JitterCompany/uartwise/pcb/serial-logger-prototype.xlsx

Sheet: BOM
Sync | Ref | Qty | Value | Footprint | MPN | Farnell | Mouser | required | stock | 2
 |  | 1 |  |  |  |  | 534-1043 | 2 |  |  | extra/alt om te proberen
1 | BT1, | 1 | Battery_Cell | Jitter_Footprints:BatteryHolder_Keystone_1043(p)_1x18650 | 1043P |  | 534-1043P | 2
1 | C1, C4, C14, C16, C13, | 5 | 100nF | Capacitor_SMD:C_0402_1005Metric |  | 2896350 |  | 10
1 | C2, C9, C7, C8, C12, C11, C18, C17, | 8 | 4.7µF | Capacitor_SMD:C_0805_2012Metric |  | 2611942 |  | 16
1 | C3, C6, | 2 | 1.0µF | Capacitor_SMD:C_0603_1608Metric |  |  |  | 0 | 12
1 | C10, C15, C5, C19, C20, | 5 | 10nF | Capacitor_SMD:C_0402_1005Metric |  | 2470416 |  | 10
1 | H1, | 1 | ELW2106AA | Jitter_Footprints:Molex_503480-1400-1x14-1MP_P0.5mm_Horizontal | 503480-1400 | 3215747 |  | 2
1 | J1, | 1 | JTAG/SWD | Connector_PinHeader_1.27mm:PinHeader_2x05_P1.27mm_Vertical_SMD | FTSH-105-01-L-DV-K-P | 2856437 | 200-FTSH10501LDVKP | 2
1 | J2, | 1 | Conn_01x04_Female | Connector_PinSocket_2.54mm:PinSocket_1x04_P2.54mm_Vertical |  | 1593460 |  | 2
1 | J3, | 1 | Conn_01x04_Male | Connector_PinHeader_2.54mm:PinHeader_1x04_P2.54mm_Horizontal |  | 2888929 |  | 2
1 | J4, | 1 | Conn_01x03_Male | Connector_PinHeader_2.54mm:PinHeader_1x03_P2.54mm_Vertical |  |  |  | 0 | 5
1 | L1, | 1 | 22µH | Inductor_SMD:L_1812_4532Metric | LQH43PN220M26L | 2219279 |  | 2
1 | R2, R1, | 2 | 220 | Resistor_SMD:R_0402_1005Metric |  | 2614287 |  | 4
1 | R7, R5, R13, | 3 | 10k | Resistor_SMD:R_0603_1608Metric |  | 1469748 |  | 6
1 | R8, R6, R3, R4, R12, | 5 | 10k | Resistor_SMD:R_0402_1005Metric |  | 1738864 |  | 10
1 | R9, R10, | 2 | 47 | Resistor_SMD:R_0402_1005Metric |  | 9232605 |  | 4
1 | R11, | 1 | 1.1M | Resistor_SMD:R_0402_1005Metric |  | 2694532 |  | 2
1 | R14, | 1 | 56k | Resistor_SMD:R_0402_1005Metric |  | 2447198 |  | 2
1 | SW1, | 1 | Rotary_Encoder_Switch_DualLED | Jitter_Footprints:PEL12D-4xxxS-Sxxxx | PEL12D-4225S-S2024 |  | 652-PEL12D4225SS2024 | 2
1 | SW2, | 1 | SW_SPDT | Jitter_Footprints:slide_switch_09.03201.02 | 09.03201.02 | 1608080 |  | 2
1 | U1, | 1 | STM32G070KBT6 | Package_QFP:LQFP-32_7x7mm_P0.8mm | STM32G070KBT6 | 3365394 | 511-STM32G070KBT6 | 2
1 | U2, | 1 | 74LVC3G17 | Package_SO:TSSOP-8_3x3mm_P0.65mm | SN74LVC3G17DCT | 1236391 |  | 2
1 | U3, | 1 | TLV70228_SOT23-5 | Package_TO_SOT_SMD:SOT-23-5 | TLV70228DBVT | 2492371 |  | 2
1 | U4, U6, | 2 | sn74lv1t34 | Package_TO_SOT_SMD:SOT-23-5 | SN74LV1T34DBVR | 3119564 | 595-SN74LV1T34DBVR | 4
1 | U5, | 1 | TLV61046ADB | Package_TO_SOT_SMD:SOT-23-6 | TLV61046ADBV | 3007283 |  | 2
 |  |  |  |  |  |  |  | 0
 |  |  |  |  |  |  |  | 0
 |  |  |  |  |  |  |  | 0
1 | TP1, TP2, TP5, TP6, TP7, TP8, TP9, | 7 | TestPoint | TestPoint:TestPoint_Pad_D1.0mm |  |  |  | 0 | 14
1 | TP4, TP3, | 2 | TestPoint | TestPoint:TestPoint_Pad_D1.5mm |  |  |  | 0 | 4
 |  |  |  |  |  |  |  | 0
 |  |  |  |  |  |  |  | 0
 |  | 1 |  | display | ELW2106AA |  | 387-ELW2106AA | 1 | 1
 |  | 3 |  | M2x14 (of M2x15, misschien zelfs x16?) |  | 2494515 |  | 6

Sheet: Sheet2
534-1043 | 2
534-1043P | 2
387-ELW2106AA | 1
200-FTSH10501LDVKP | 2
652-PEL12D4225SS2024 | 2
511-STM32G070KBT6 | 2
595-SN74LV1T34DBVR | 4
