JitterCompany/uartwise/pcb/production/Jitter-1111_L1-1__100x30__acryl-zwart-2mm.dxf

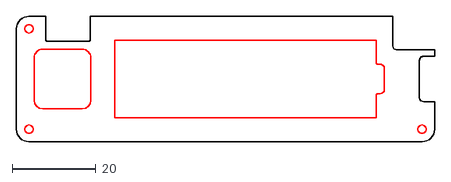
[picture p1: CAD file, 2020-02-04]
pcb/production/Jitter-1111_L1-1__100x30__acryl-zwart-2mm.dxf
100.0 x 30.0
