JitterCompany/uartwise/pcb/production/Jitter-1111_L2-1__100x30__acryl-transparant-2mm.dxf

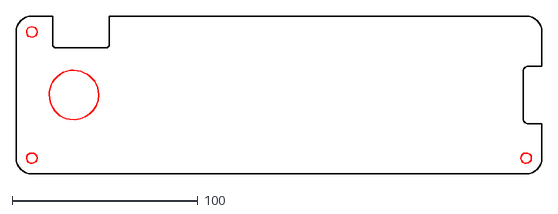
[picture p2: CAD file, 2020-02-04]
pcb/production/Jitter-1111_L2-1__100x30__acryl-transparant-2mm.dxf
283.5 x 85.0
