JitterCompany/uartwise/pcb/production/Jitter-1111_L0-1__100x30__acryl-zwart-6mm.dxf

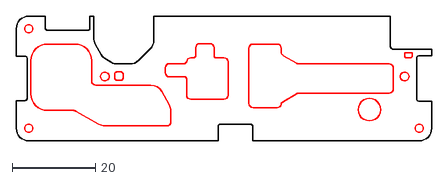
[picture p3: CAD file, 2020-02-04]
pcb/production/Jitter-1111_L0-1__100x30__acryl-zwart-6mm.dxf
100.0 x 30.0
