JitterCompany/uartwise/pcb/serial-logger-prototype.kicad_pcb

## KiCad design pcb/serial-logger-prototype.kicad_pcb (2020-03-20)

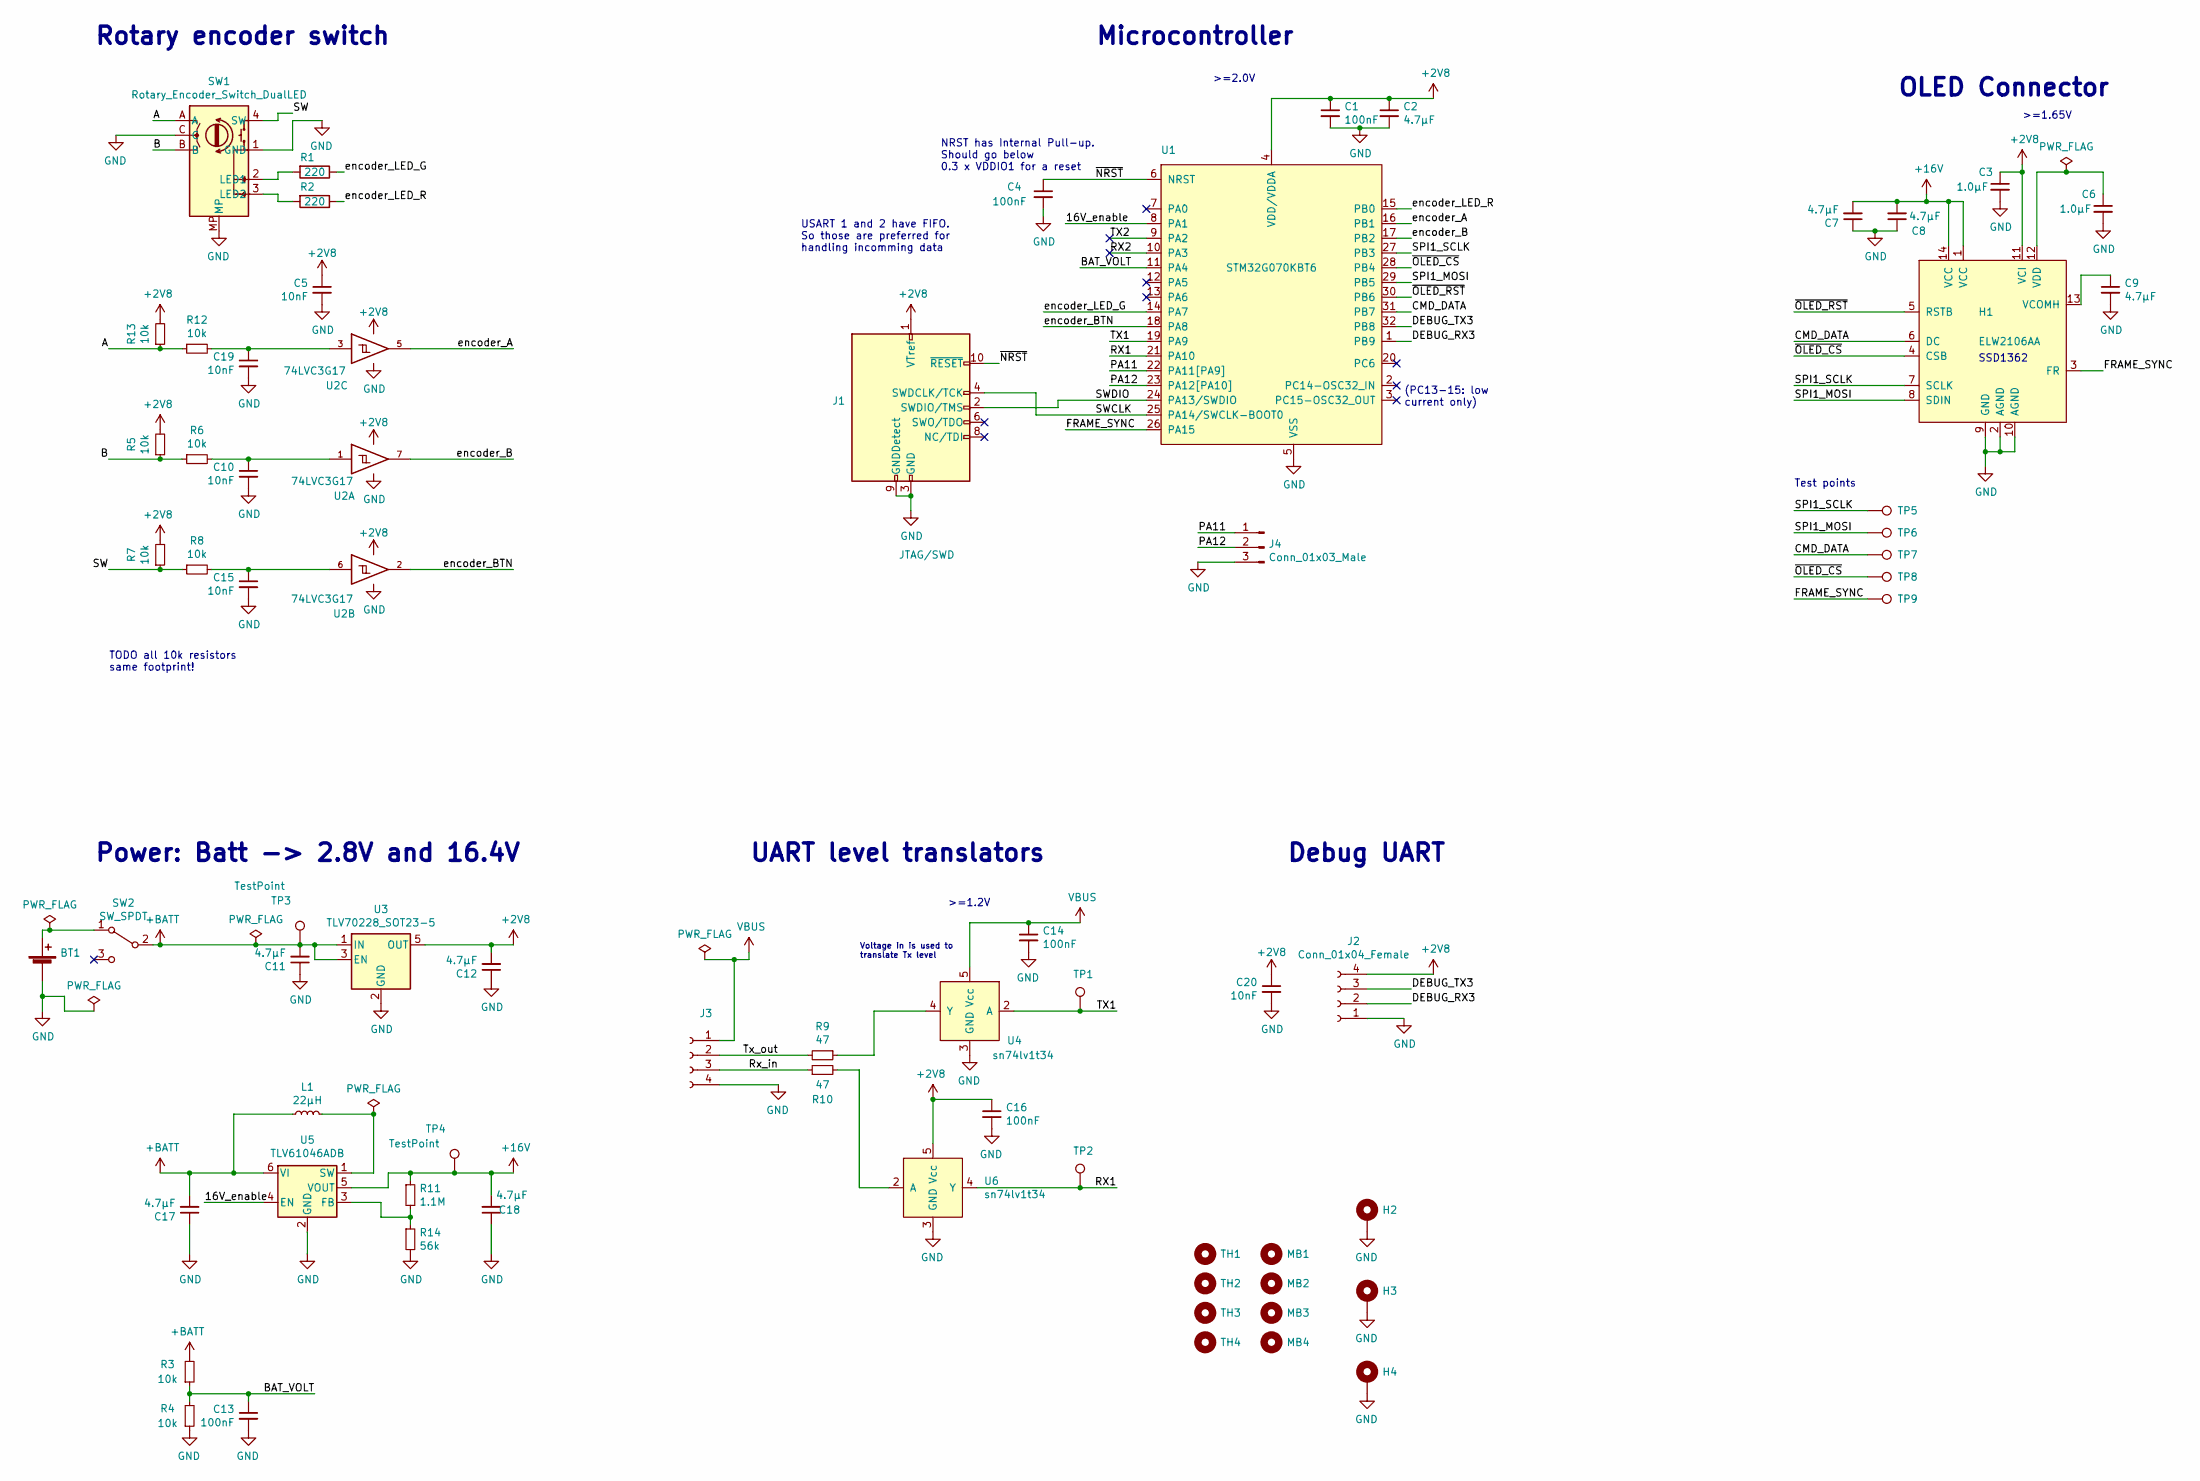
[picture p4: schematic serial-logger-prototype.sch]

Parts:
BT1: Battery_Cell; BatteryHolder_Keystone_1043(p)_1x18650; MPN 1043P; Mouser 534-1043P
C1, C4, C13, C14, C16: 100nF; C_0402_1005Metric
C2, C7, C8, C9, C11, C12, C17, C18: 4.7µF; C_0805_2012Metric
C3, C6: 1.0µF; C_0603_1608Metric
C5, C10, C15, C19, C20: 10nF; C_0402_1005Metric
H1: ELW2106AA; Molex_503480-1400-1x14-1MP_P0.5mm_Horizontal; MPN 503480-1400; Farnell 3215747
H2, H3, H4: DNI; MountingHole_2.2mm_M2_Pad_Via
J1: JTAG/SWD; PinHeader_2x05_P1.27mm_Vertical_SMD; MPN FTSH-105-01-L-DV-K-P; Farnell 2856437
J2: Conn_01x04_Female; PinSocket_1x04_P2.54mm_Vertical; Farnell 1593460
J3: Conn_01x04_Male; PinHeader_1x04_P2.54mm_Horizontal; Farnell 2888929
J4: Conn_01x03_Male; PinHeader_1x03_P2.54mm_Vertical
L1: 22µH; L_1812_4532Metric; MPN LQH43PN220M26L; Farnell 2219279
MB1, MB2, MB3, MB4: DNI; MouseBite_3.5mmx2.2mm_breakaway
R1, R2: 220; R_0402_1005Metric
R3, R4, R6, R8, R12: 10k; R_0402_1005Metric
R5, R7, R13: 10k; R_0603_1608Metric
R9, R10: 47; R_0402_1005Metric
R11: 1.1M; R_0402_1005Metric
R14: 56k; R_0402_1005Metric
SW1: Rotary_Encoder_Switch_DualLED; PEL12D-4xxxS-Sxxxx; MPN PEL12D-4225S-S2024; Mouser 652-PEL12D4225SS2024
SW2: SW_SPDT; slide_switch_09.03201.02; MPN 09.03201.02; Farnell 1608080
TH1, TH2, TH3, TH4: DNI; Tooling_hole_4mm_4.04mm_paste
TP1, TP2, TP5, TP6, TP7, TP8, TP9: TestPoint; TestPoint_Pad_D1.0mm
TP3, TP4: TestPoint; TestPoint_Pad_D1.5mm
U1: STM32G070KBT6; LQFP-32_7x7mm_P0.8mm; MPN STM32G070KBT6; Farnell 3365394
U2: 74LVC3G17; TSSOP-8_3x3mm_P0.65mm; MPN SN74LVC3G17DCT; Farnell 1236391
U3: TLV70228_SOT23-5; SOT-23-5; MPN TLV70228DBVT; Farnell 2492371
U4, U6: sn74lv1t34; SOT-23-5; MPN SN74LV1T34DBVR; Mouser 595-SN74LV1T34DBVR
U5: TLV61046ADB; SOT-23-6; MPN TLV61046ADBV; Farnell 3007283

Connections:
+2V8: C1.1, C2.1, C3.1, C5.1, C12.2, C16.1, C20.1, H1.11 (VCI), J1.1 (VTref), J2.4, R5.2, R7.2, R13.2, U1.4 (VDD/VDDA), U2.8 (VCC), U3.5 (OUT), U6.5 (Vcc)
+16V: C7.2, C8.2, C18.2, H1.1 (VCC), H1.14 (VCC), R11.1, TP4.1, U5.5 (VOUT)
+BATT: C11.2, C17.2, L1.1, R3.2, SW2.2 (B), TP3.1, U3.1 (IN), U3.3 (EN), U5.6 (VI)
/16V_enable: U1.8 (PA1), U5.4 (EN)
/A: R12.1, R13.1, SW1.A
/B: R5.1, R6.1, SW1.B
/BAT_VOLT: C13.1, R3.1, R4.2, U1.11 (PA4)
/CMD_DATA: H1.6 (DC), TP7.1, U1.31 (PB7)
/DEBUG_RX3: J2.2, U1.1 (PB9)
/DEBUG_TX3: J2.3, U1.32 (PB8)
/FRAME_SYNC: H1.3 (FR), TP9.1, U1.26 (PA15)
/PA11: J4.1, U1.22 (PA11[PA9])
/PA12: J4.2, U1.23 (PA12[PA10])
/RX1: TP2.1, U1.21 (PA10), U6.4 (Y)
/Rx_in: J3.3, R10.1
/SPI1_MOSI: H1.8 (SDIN), TP6.1, U1.29 (PB5)
/SPI1_SCLK: H1.7 (SCLK), TP5.1, U1.27 (PB3)
/SW: R7.1, R8.1, SW1.4 (SW)
/SWCLK: J1.4 (SWDCLK/TCK), U1.25 (PA14/SWCLK-BOOT0)
/SWDIO: J1.2 (SWDIO/TMS), U1.24 (PA13/SWDIO)
/TX1: TP1.1, U1.19 (PA9), U4.2 (A)
/Tx_out: J3.2, R9.2
/encoder_A: U1.16 (PB1), U2.5
/encoder_B: U1.17 (PB2), U2.7
/encoder_BTN: U1.18 (PA8), U2.2
/encoder_LED_G: R1.1, U1.14 (PA7)
/encoder_LED_R: R2.1, U1.15 (PB0)
/~NRST: C4.1, J1.10 (~RESET~), U1.6 (NRST)
/~OLED_CS: H1.4 (CSB), TP8.1, U1.28 (PB4)
/~OLED_RST: H1.5 (RSTB), U1.30 (PB6)
GND: BT1.2 (-), C1.2, C2.2, C3.2, C4.2, C5.2, C6.2, C7.1, C8.1, C9.2, C10.2, C11.1, C12.1, C13.2, C14.2, C15.2, C16.2, C17.1, C18.1, C19.2, C20.2, H1.2 (AGND), H1.9 (GND), H1.10 (AGND), H2.1, H3.1, H4.1, J1.3 (GND), J1.5 (GND), J1.9 (GNDDetect), J2.1, J3.4, J4.3, R4.1, R14.2, SW1.1 (GND), SW1.C, SW1.MP, U1.5 (VSS), U2.4 (GND), U3.2 (GND), U4.3 (GND), U5.2 (GND), U6.3 (GND)
unnamed: BT1.1 (+), SW2.1 (A)
unnamed: C6.1, H1.12 (VDD)
unnamed: C9.1, H1.13 (VCOMH)
unnamed: C10.1, R6.2, U2.1
unnamed: C15.1, R8.2, U2.6
unnamed: C19.1, R12.2, U2.3
unnamed: L1.2, U5.1 (SW)
unnamed: R1.2, SW1.2 (LED1)
unnamed: R2.2, SW1.3 (LED2)
unnamed: R9.1, U4.4 (Y)
unnamed: R10.2, U6.2 (A)
unnamed: R11.2, R14.1, U5.3 (FB)
VBUS: C14.1, J3.1, U4.5 (Vcc)

Notes on the sheet:
USART 1 and 2 have FIFO. So those are preferred for handling incomming data
NRST has Internal Pull-up. Should go below 0.3 x VDDIO1 for a reset
SSD1362
OLED Connector
Microcontroller
Power: Batt -> 2.8V and 16.4V
UART level translators
Voltage in is used to translate Tx level
Debug UART
>=1.65V
>=1.2V
>=2.0V
(PC13-15: low current only)
Rotary encoder switch
Test points
TODO all 10k resistors same footprint!

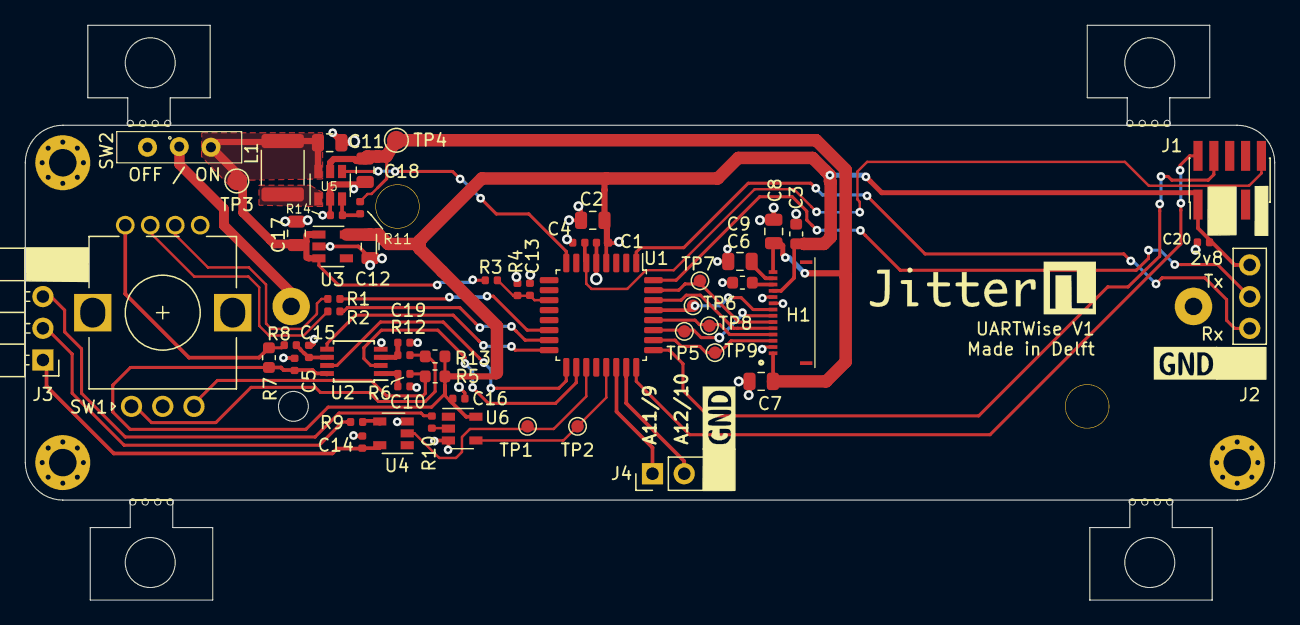
[picture p5: board serial-logger-prototype.kicad_pcb from above]

Board: 2 copper layers, 100.0 x 46.0 mm, 69 parts (1 on the bottom side), 44 nets.
