JitterCompany/uartwise/firmware/src/main.rs

#![no_std]
#![no_main]

use core::fmt::Write;

// pick a panicking behavior
extern crate panic_halt; // you can put a breakpoint on `rust_begin_unwind` to catch panics

use display_interface_spi::SPIInterface;
use arrayvec::ArrayString;

use embedded_hal as hal;
use hal::digital::v2::OutputPin;

mod encoder;
use encoder::{Encoder, Channel};

use nb;

use stm32g0xx_hal::{
    prelude::*,
    stm32::{self, SPI1, EXTI, TIM15},
    spi,
    serial::{self, FullConfig, FifoThreshold, Error as SerialError},
    gpio,
    timer::Timer,
    exti::Event,
    rcc,
    delay::Delay
};

use ssd1362::{self, display::DisplayRotation, terminal, Font6x8};

type Terminal = terminal::TerminalView<SPIInterface<
    spi::Spi<
        SPI1,
        (
            gpio::gpiob::PB3<gpio::Input<gpio::Floating>>,
            gpio::gpioa::PA6<gpio::Input<gpio::Floating>>,
            gpio::gpiob::PB5<gpio::Input<gpio::Floating>>
        )
    >,
    gpio::gpiob::PB7<gpio::Output<gpio::PushPull>>,
    gpio::gpiob::PB4<gpio::Output<gpio::PushPull>>
    >,
    Font6x8
    >;

type Enc = Encoder<
    gpio::gpiob::PB<gpio::Input<gpio::PushPull>>,
    gpio::gpiob::PB<gpio::Input<gpio::PushPull>>
    >;

#[rtic::app(device = stm32g0xx_hal::stm32)]
const APP: () = {

    struct Resources {
        terminal: Terminal,
        led_r: gpio::gpiob::PB0<gpio::Output<gpio::PushPull>>,
        led_g: gpio::gpioa::PA7<gpio::Output<gpio::PushPull>>,
        timer: Timer<stm32::TIM1>,
        exti: EXTI,
        encoder: Enc,
        tx: serial::Tx<stm32::USART1, FullConfig>,
        rx: serial::Rx<stm32::USART1, FullConfig>,
        uart_in_buffer: ArrayString::<[u8; 1024]>,
        debug_pin1: gpio::gpiob::PB8<gpio::Output<gpio::PushPull>>,
        debug_pin2: gpio::gpiob::PB9<gpio::Output<gpio::PushPull>>,
        debug_pin3: gpio::gpioa::PA11<gpio::Output<gpio::PushPull>>,
        debug_pin4: gpio::gpioa::PA12<gpio::Output<gpio::PushPull>>,
        delay: Delay<TIM15>
    }

    #[init(spawn = [startup])]
    fn init(cx: init::Context) -> init::LateResources {

        let dp = stm32::Peripherals::take().expect("cannot take peripherals");

        let pll_cfg = rcc::PllConfig::default();
        let rcc_cfg = rcc::Config::pll().pll_cfg(pll_cfg);
        let mut rcc = dp.RCC.freeze(rcc_cfg);

        let mut delay = dp.TIM15.delay(&mut rcc);

        let gpioa = dp.GPIOA.split(&mut rcc);
        let gpiob = dp.GPIOB.split(&mut rcc);
        let _gpioc = dp.GPIOC.split(&mut rcc);



        // let mut led = gpioa.pa5.into_push_pull_output();
        let mut led_g = gpioa.pa7.into_push_pull_output();
        let led_r = gpiob.pb0.into_push_pull_output();
        let mut en_16v = gpioa.pa1.into_push_pull_output();

        let mut exti = dp.EXTI;

        let encoder = {
            let encoder_a = gpiob.pb1.listen( gpio::SignalEdge::Rising, &mut exti).downgrade();
            let encoder_b = gpiob.pb2.listen(gpio::SignalEdge::Rising, &mut exti).downgrade();
            Encoder::new(encoder_a, encoder_b)
        };

        let btn = gpioa.pa8.into_pull_up_input();
        btn.listen(gpio::SignalEdge::Falling, &mut exti);

        let mut cs = gpiob.pb4.into_push_pull_output(); // blue 13
        cs.set_high().unwrap();

        // d/c pin for toggling between data/cmd
        // dc low = command, dc high = data
        let mut dc = gpiob.pb7.into_push_pull_output(); // orange
        dc.set_low().unwrap();

        let mut rst = gpiob.pb6.into_push_pull_output();
        rst.set_high().unwrap();

        let mut usart = dp.USART1.usart( gpioa.pa9, gpioa.pa10,
            FullConfig::default()
                .baudrate(115200.bps())
                .fifo_enable()
                .rx_fifo_threshold(FifoThreshold::FIFO_4_BYTES)
                .rx_fifo_enable_interrupt()
                .receiver_timeout_us(25_000),
            &mut rcc).unwrap();

        writeln!(usart, "Hello SerialLogger\n").unwrap();

        led_g.set_high().unwrap();
        delay.delay(2500.ms());
        led_g.set_low().unwrap();

        let sck = gpiob.pb3; // yellow 10
        let miso = gpioa.pa6; //not used
        let mosi = gpiob.pb5; // green 9
        let spi = dp.SPI1.spi(
            (sck, miso, mosi),
            spi::MODE_0,
            10.mhz(),
            &mut rcc);


        writeln!(usart, "Start!").unwrap();

        // do power on reset
        rst.set_low().unwrap();
        delay.delay(1.ms());
        rst.set_high().unwrap();


        writeln!(usart, "Turn on VCC!").unwrap();
        en_16v.set_high().unwrap();

        let interface = display_interface_spi::SPIInterface::new(spi, dc, cs);
        let display = ssd1362::display::Display::new(interface, DisplayRotation::Rotate180);
        writeln!(usart, "create terminal..").unwrap();
        let font = terminal::Font6x8 {};
        let mut terminal = terminal::TerminalView::new(display, font);
        terminal.init().unwrap();

        writeln!(usart, "Display init done!").unwrap();
        writeln!(terminal, "Display init done!").unwrap();
        writeln!(terminal, " -> ").unwrap();

        terminal.render().unwrap();
        let mut timer = dp.TIM1.timer(&mut rcc);
        timer.start(10.hz());
        timer.listen();

        let (tx, rx) = usart.split();

        // rx.listen();

        let mut debug_pin1 = gpiob.pb8.into_push_pull_output();
        debug_pin1.set_low().unwrap();

        let mut debug_pin2 = gpiob.pb9.into_push_pull_output();
        debug_pin2.set_low().unwrap();

        let mut debug_pin3 = gpioa.pa11.into_push_pull_output();
        debug_pin3.set_low().unwrap();

        let mut debug_pin4 = gpioa.pa12.into_push_pull_output();
        debug_pin4.set_low().unwrap();

        cx.spawn.startup().ok();

        init::LateResources {
            terminal,
            led_r,
            led_g,
            timer,
            exti,
            encoder,
            tx,
            rx,
            uart_in_buffer: ArrayString::new(),
            debug_pin1,
            debug_pin2,
            debug_pin3,
            debug_pin4,
            delay
        }
    }

    #[task(resources=[])]
    fn startup(_cx: startup::Context) {
    }

    #[task(binds=TIM1_BRK_UP_TRG_COM, resources = [timer, terminal, debug_pin3], priority = 3, spawn = [])]
    fn timer(cx: timer::Context) {
        let timer::Resources {
            timer,
            terminal,
            debug_pin3,
        } = cx.resources;

        debug_pin3.set_high().unwrap();
        terminal.render().unwrap();
        debug_pin3.set_low().unwrap();

        timer.clear_irq();

    }

    #[task(binds=EXTI0_1, resources = [exti, encoder], priority = 4, spawn = [])]
    fn encoder_a(cx: encoder_a::Context) {

        let encoder_a::Resources {
            exti,
            encoder,
        } = cx.resources;

        if exti.is_pending(Event::GPIO1, gpio::SignalEdge::Rising) {
            let (position, _step) = encoder.update(Channel::A);
            exti.unpend(Event::GPIO1);
        }
    }

    #[task(binds=EXTI2_3, resources = [exti, encoder, tx], priority = 4, spawn = [])]
    fn encoder_b(cx: encoder_b::Context) {
        let encoder_b::Resources {
            exti,
            encoder,
            tx
        } = cx.resources;

        if exti.is_pending(Event::GPIO2, gpio::SignalEdge::Rising) {
            let (position, _step) = encoder.update(Channel::B);
            exti.unpend(Event::GPIO2);
            writeln!(tx, "encoder b: {}", position).unwrap();
        }
    }

    #[task(binds=EXTI4_15, resources = [tx, exti], priority = 1, spawn = [])]
    fn button(cx: button::Context) {
        let button::Resources {
            mut tx,
            mut exti,
        } = cx.resources;

        exti.lock(|exti| {
            if exti.is_pending(Event::GPIO8, gpio::SignalEdge::Falling) {
                exti.unpend(Event::GPIO8);
            }
        });
        tx.lock(|tx| writeln!(tx, " <== button ==>").unwrap());
    }

    #[task(priority = 1, resources=[terminal, uart_in_buffer], capacity = 100)]
    fn uart_buffer(cx: uart_buffer::Context, byte: u8) { //Result<u8, nb::Error<serial::Error>>) {

        let uart_buffer::Resources {
            mut terminal,
            uart_in_buffer
        } = cx.resources;

        let b = byte;
        match uart_in_buffer.try_push(b as char) {
            Ok(_n)  => {},
            Err(_buffer_error) => {
                // uart_in_buffer.clear();
                return;
            }
        }

        if b == b'\n' {
            let string = &uart_in_buffer[0..uart_in_buffer.len()];
            terminal.lock(|terminal| terminal.write_string(string).unwrap());
            uart_in_buffer.clear();

        }
    }

    #[task(binds = USART1, resources = [rx, led_r, debug_pin1,debug_pin2], priority = 4, spawn=[uart_buffer])]
    fn usart_in(cx: usart_in::Context) {

        let usart_in::Resources {
            rx,
            led_r,
            debug_pin1,
            debug_pin2
        } = cx.resources;

        debug_pin1.set_high().unwrap();

        loop {
            match rx.read() {
                Err(nb::Error::WouldBlock) => {
                    break;
                },
                Err(nb::Error::Other(err)) => {
                    led_r.set_high().unwrap();
                    match err {
                        SerialError::Overrun => {
                            cx.spawn.uart_buffer('O' as u8).ok();
                            debug_pin2.set_high().unwrap();
                        },
                        SerialError::Framing => {
                            cx.spawn.uart_buffer('F' as u8).ok();
                        }
                        SerialError::Noise => {
                            cx.spawn.uart_buffer('N' as u8).ok();
                        },
                        SerialError::Parity => {
                            cx.spawn.uart_buffer('P' as u8).ok();
                        }
                    }
                    cx.spawn.uart_buffer('\n' as u8).ok();
                },
                Ok(byte) => {
                    cx.spawn.uart_buffer(byte).ok();
                },
            }
        }

        if rx.timeout_lapsed() {
            rx.clear_timeout();
        }

        debug_pin1.set_low().unwrap();
        debug_pin2.set_low().unwrap();
    }


     // Interrupt handlers used to dispatch software tasks
     extern "C" {
        fn SPI2();
        fn I2C1();
    }

};
