JitterCompany/uartwise/(commit log)

2020-01-08 Add pcb directory
    [seral-logger-prototype.kicad_pcb, seral-logger-prototype.sch]
2020-01-08 Finish schematics (for now)
    All footprints complete except on/off switch (depends on enclosure)
    TODO: pin swapping for easier routing
    [seral-logger-prototype.sch]
2020-01-08 First Trial placement of components on pcb
    [seral-logger-prototype.kicad_pcb, seral-logger-prototype.sch]
2020-01-09 Layout seems plausible: start routing
    [seral-logger-prototype.kicad_pcb, seral-logger-prototype.sch]
2020-01-10 Finish routing and pin swapping
    [seral-logger-prototype.kicad_pcb, seral-logger-prototype.sch]
2020-01-10 Improve some routing
    [seral-logger-prototype.kicad_pcb]
2020-01-10 Update slide switch placement and add mounting hole
    [seral-logger-prototype.kicad_pcb, seral-logger-prototype.sch]
2020-01-10 Uptimize component placement to make room for enclosure
    [seral-logger-prototype.kicad_pcb]
2020-01-10 Add silklayer at bottom side
    [seral-logger-prototype.kicad_pcb]
2020-01-10 Add rounded corners to board outline
    [seral-logger-prototype.kicad_pcb]
2020-01-10 Fix silk screen overlap
    [seral-logger-prototype.kicad_pcb]
2020-01-29 Fix typo in filenames
    [serial-logger-prototype.kicad_pcb, serial-logger-prototype.sch]
2020-01-29 Add note about PC13-15
    [serial-logger-prototype.sch]
2020-01-30 Schematics: implement BATT_VOLT, shuffle schematics blocks around
    [serial-logger-prototype.sch]
2020-01-30 Add pinMapping xlsx sheet
    [pinMapping_stm32g070cb.xlsx]
2020-01-30 Add working proof of concept for ELW2106AA OLED display
    Based on SSD1362 driver IC
    [pinMapping_stm32g070cb.xlsx]
2020-02-04 PCB: cleanup layout, optimize for 3d enclosure
    [serial-logger-prototype.kicad_pcb, serial-logger-prototype.sch]
2020-02-04 PCB: tweak placements + silk screen
    [serial-logger-prototype.kicad_pcb, serial-logger-prototype.sch]
2020-02-04 PCB: finalize design (DRC pass)
    [serial-logger-prototype.kicad_pcb, serial-logger-prototype.sch]
2020-02-04 Schematics: annotate
    [serial-logger-prototype.sch]
2020-02-04 Add lasercut drawings + all production files
    [Jitter-1111_L0-1__100x30__acryl-zwart-6mm.dxf, Jitter-1111_L1-1__100x30__acryl-zwart-2mm.dxf, Jitter-1111_L2-1__100x30__acryl-transparant-2mm.dxf]
2020-02-05 Production gerber: rename to include dimensions
2020-02-05 Production gerber: rename to correct dimensions...
2020-02-05 Implement OLED Command Enum.
    Based on SSD1306 crate, but with correct values.
    [command.rs, interface.rs, main.rs]
2020-02-10 Add Final production BOM
    [serial-logger-prototype.sch, serial-logger-prototype.xlsx]
2020-02-10 Fix BOM: add display as separate item
    [serial-logger-prototype.sch, serial-logger-prototype.xlsx]
2020-03-20 unknown layout update
    [serial-logger-prototype.kicad_pcb]
2020-06-05 listen to pn interrupts from encoder and button
2020-06-05 Create encoder object and clean up a bit
2020-07-01 Basic example of uart -> oled
    However the uart interrupt is not handled fast enough causing overrun
    errors. Even on optimize=2 with baudrate 9600. Next step is to implement
    DMA to overcome this issue.
    [serial-logger-prototype.sch]
2020-07-08 Schematics: add note for next revision
    [serial-logger-prototype.sch]
2020-08-07 Fix uart overrun issue.
    The problem was that ALL interrupts are disabled when any .lock() is
    issued inside any task. By rearranging priorites, we now don't need a
    lock on terminal.render(). So the critical sections are minimized so
    that the uart interrupt is not unecessary blocked.
    This is an issue with RTIC on Cortex M0.
    [main.rs]
